AyanGarg2/Low-Power-NTT-Hardware-Accelerator-for-Lattice-Based-Post-Quantum-Cryptography/ASIC.jpeg

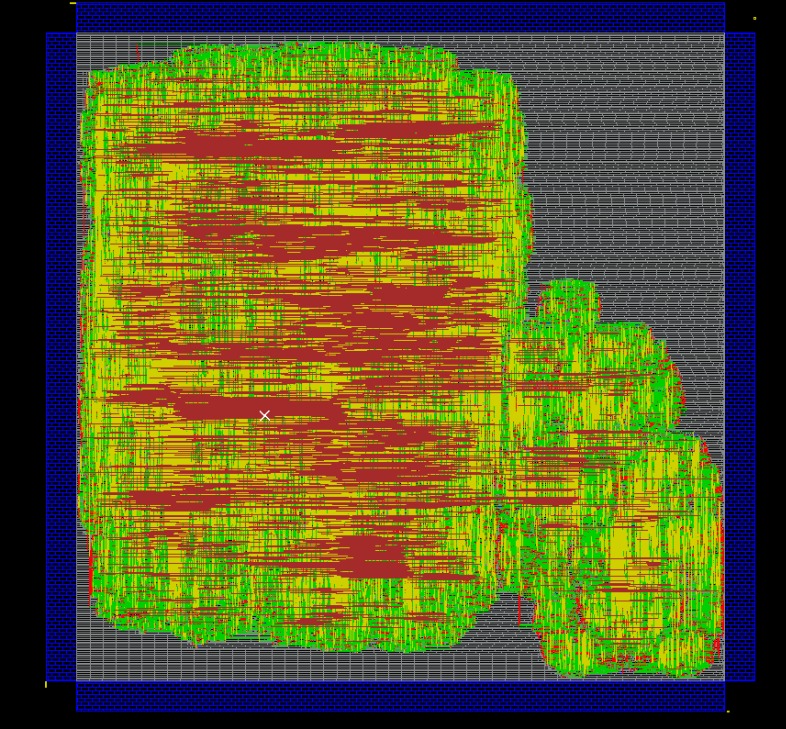
ASIC.jpeg
