AyanGarg2/Low-Power-NTT-Hardware-Accelerator-for-Lattice-Based-Post-Quantum-Cryptography/Low Power Presentation.pdf

## Efficient and Flexible Low-Power NTT for Lattice-Based Cryptography

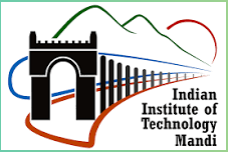
[picture p3: figure]

## Submitted To

### Dr. Srinivasu Bodapati (Associate Professor) School of Computing and Electrical Engineering Indian Institute of Technology Mandi

### Presented by Krishna Gorai(T25111), Achal Shah(T25119), Ayan Garg(B23484)

1

2

# Problem Statement

Classical cryptographic systems such as RSA and ECC are vulnerable to attacks from quantum computers.
Lattice-based cryptography has emerged as a promising post-quantum solution, but it relies heavily on polynomial multiplication.
Polynomial multiplication using conventional methods is computationally expensive and inefficient for hardware implementation.
The Number Theoretic Transform (NTT) enables faster computation, but existing implementations face challenges in power consumption and hardware complexity.

Objective:
Design an efficient and low-power hardware architecture for NTT/INTT operations suitable for lattice-based cryptographic systems.

# NTT: Number Theoretic Transform

What is NTT
A variant of FFT operating over a finite field (integers mod q) instead of complex numbers

C = NTT [ NTT(a) ∘ NTT(b)]

-1
Where ∘ = point wise multiplication

Native Multiplication: Too slow for large n, hardware dividers needed O(n²)
NTT Multiplication: n·log(n) clock cycles, single-port RAM O(n log n)

NTT hardware advantages:
1.Integer-only math
2.Small LUT (log n)

3

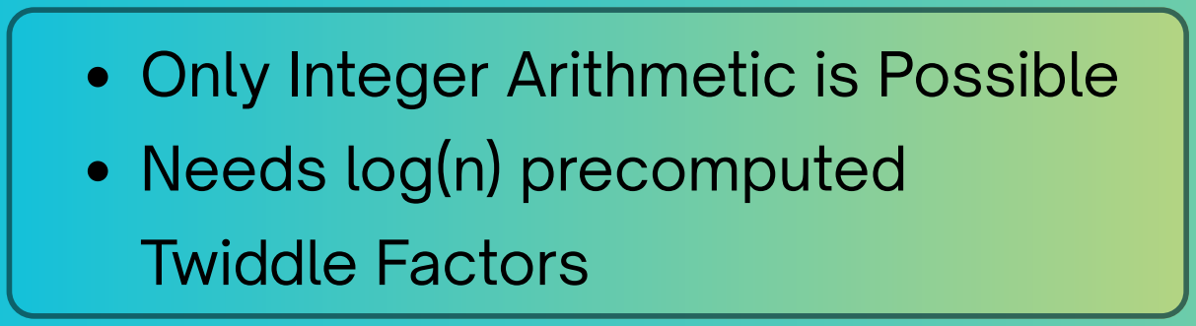
[picture p4: figure]
Only Integer Arithmetic is Possible Needs log(n) precomputed Twiddle Factors

# Algorithm: NTT Transform

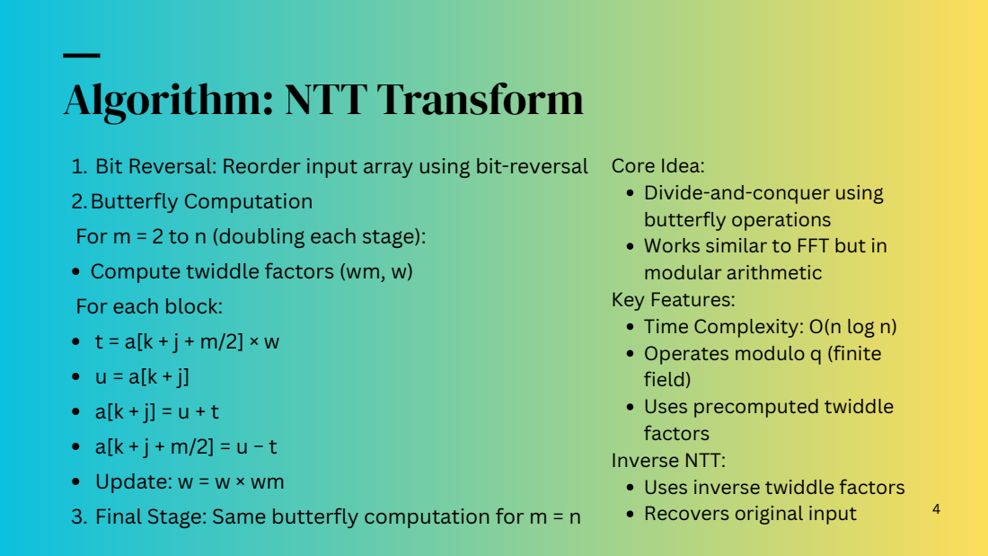
[picture p5: page 4]

1. Bit Reversal: Reorder input array using bit-reversal
2.Butterfly Computation
For m = 2 to n (doubling each stage):
Compute twiddle factors (wm, w)
For each block:
Update: w = w × wm
3. Final Stage: Same butterfly computation for m = n

Core Idea:
Divide-and-conquer using
butterfly operations
Works similar to FFT but in
modular arithmetic
Key Features:
Time Complexity: O(n log n)
Operates modulo q (finite
field)
Uses precomputed twiddle
factors
Inverse NTT:
Uses inverse twiddle factors
Recovers original input

# Algorithm: Barrett Modulo Reduction

### Input: Integer a, constants m and k Output: a mod q Steps: 1.u = (a × m) >> k 2.u = u × q 3.a = a − u 4.If a ≥ q → a = a − q Key Idea: Replaces division with multiplication + shift Efficient for hardware (used in NTT, cryptography)

5

# Algorithm: Montgomery Modulo Reduction

Input: Integer a (Montgomery form), constants R, log(R), q′
Output: a mod q
Steps:
1. u = a × q′
2. u = u AND (R − 1)
3. a = a + (u × q)
4. a = a >> log(R)
5. If a ≥ q → a = a − q
Key Idea:
Replaces division with multiplication, masking, and shift
Efficient for hardware and large integer arithmetic (used in cryptography, NTT)

6

# Algorithm: Optimized NTT Transform(First Round)

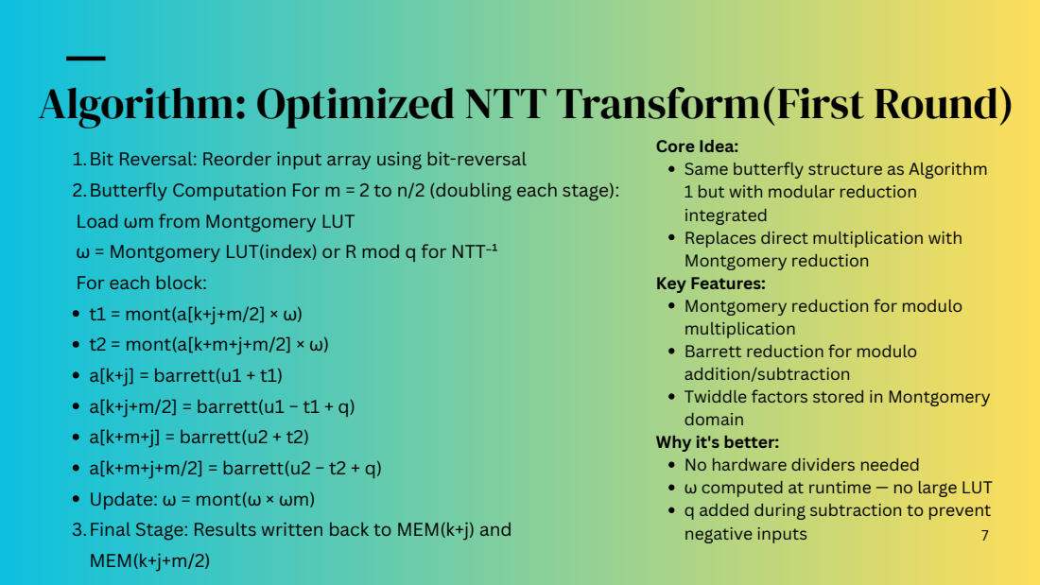
[picture p6: page 7]
negative inputs

Core Idea:
Same butterfly structure as Algorithm
1 but with modular reduction
integrated
Replaces direct multiplication with
Montgomery reduction
Key Features:
Montgomery reduction for modulo
multiplication
Barrett reduction for modulo
addition/subtraction
Twiddle factors stored in Montgomery
domain
Why it's better:
No hardware dividers needed
ω computed at runtime — no large LUT
q added during subtraction to prevent

1.Bit Reversal: Reorder input array using bit-reversal
2.Butterfly Computation For m = 2 to n/2 (doubling each stage):
Load ωm from Montgomery LUT
ω = Montgomery LUT(index) or R mod q for NTT⁻¹
For each block:
t1 = mont(a[k+j+m/2] × ω)
t2 = mont(a[k+m+j+m/2] × ω)
a[k+j] = barrett(u1 + t1)
a[k+j+m/2] = barrett(u1 − t1 + q)
a[k+m+j] = barrett(u2 + t2)
a[k+m+j+m/2] = barrett(u2 − t2 + q)
Update: ω = mont(ω × ωm)
3.Final Stage: Results written back to MEM(k+j) and
MEM(k+j+m/2)

# Algorithm: Optimized NTT Transform(Last Round)

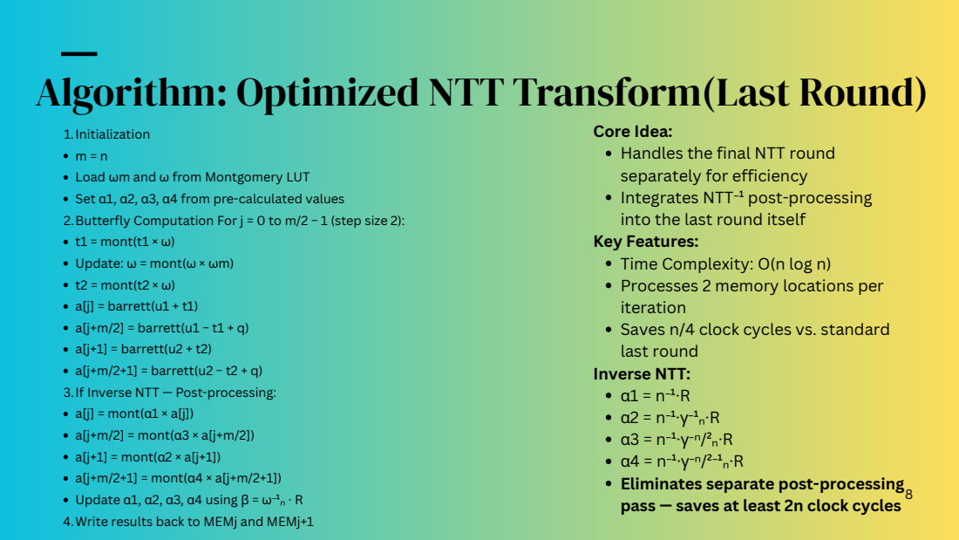
[picture p7: page 8]

Core Idea:
Handles the final NTT round
separately for efficiency
Integrates NTT⁻¹ post-processing
into the last round itself
Key Features:
Time Complexity: O(n log n)
Processes 2 memory locations per
iteration
Saves n/4 clock cycles vs. standard
last round
Inverse NTT:
Eliminates separate post-processing
pass — saves at least 2n clock cycles

1.Initialization
Load ωm and ω from Montgomery LUT
Set α1, α2, α3, α4 from pre-calculated values
2.Butterfly Computation For j = 0 to m/2 − 1 (step size 2):
t1 = mont(t1 × ω)
Update: ω = mont(ω × ωm)
t2 = mont(t2 × ω)
a[j] = barrett(u1 + t1)
a[j+m/2] = barrett(u1 − t1 + q)
a[j+1] = barrett(u2 + t2)
a[j+m/2+1] = barrett(u2 − t2 + q)
3.If Inverse NTT — Post-processing:
a[j] = mont(α1 × a[j])
a[j+m/2] = mont(α3 × a[j+m/2])
a[j+1] = mont(α2 × a[j+1])
a[j+m/2+1] = mont(α4 × a[j+m/2+1])
Update α1, α2, α3, α4 using β = ω⁻¹
4.Write results back to MEMj and MEMj+1

# Architecture of optimised NTT/INTT Transform

Four Main Modules:
RAM: Stores two 16-bit coefficients per 32-bit memory line.
Address Unit: Controls read/write addresses for RAM access.
ω/α Update Unit — Updates twiddle factor ω and scaling factors α1–α4 each cycle. Core Operation: Butterfly unit performing Montgomery multiplication and Barrett reduction.
Registers:
H1, L1: Hold high and low 16-bit coefficients from RAM.
R1–R5: Store intermediate results and enable coefficient swapping.
Red components — Additional multipliers active only during NTT⁻¹.

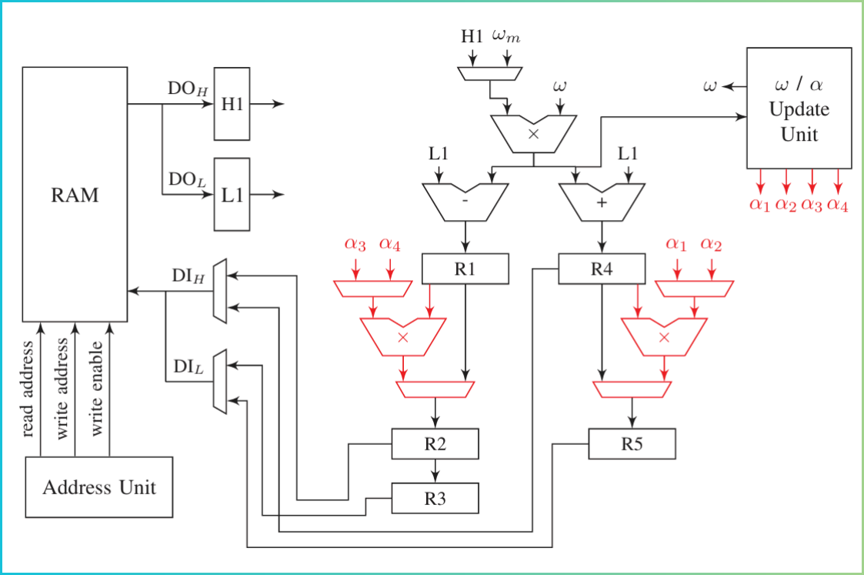
[picture p8: figure]

[1] T. Fritzmann and J. Sepulveda,

"Efficient and Flexible Low-Power NTT for Lattice-Based Cryptography,

" in Proc. IEEE HOST, McLean, VA, USA, 2019, pp. 141–150.

9

# Power Optimisation Techniques

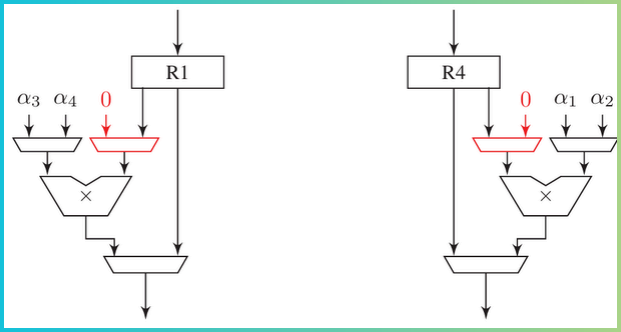
[picture p9: figure]
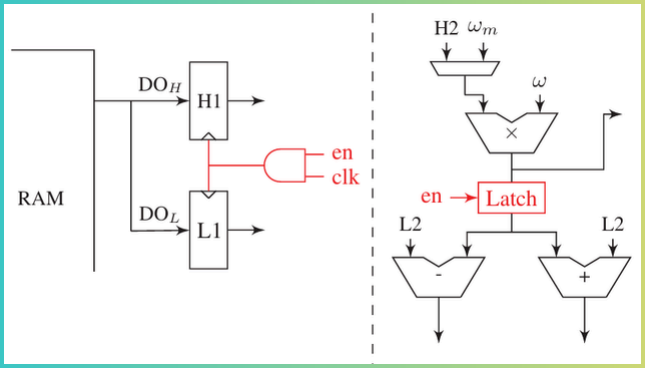
[picture p10: figure]

Operand Isolation: NTT⁻¹ Multipliers Operand Isolation: Input Registers

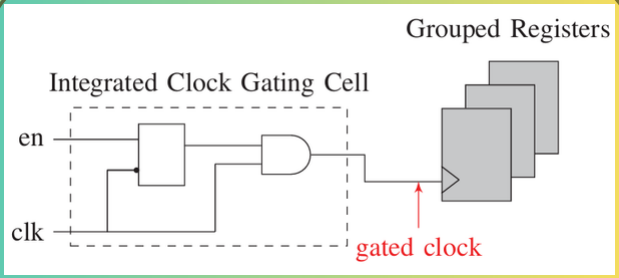
[picture p11: figure]

Clock Gating: Integrated Clock Gating Cell

Inputs to α multipliers are forced to
zero outside the last round, preventing unnecessary switching and reducing dynamic power.

Registers with a common enable signal are grouped. A gated clock disables inactive registers, reducing dynamic power to zero during idle cycles.

H1 and L1 are clock-gated during write cycles. A latch after the first multiplier blocks results from propagating when not needed.

[1] T. Fritzmann and J. Sepulveda, "Efficient and Flexible Low-Power NTT for Lattice-Based Cryptography," in Proc. IEEE HOST, McLean, VA, USA, 2019, pp. 141–150.

10

Resource | Used | Avail. | Util% | Paper[1]
LUT as Logic | 953 | 53,200 | 1.79 | —
LUT as Dist.RAM | 268 | 17,400 | 1.54 | —
LUT total | 1,221 | 53,200 | 2.30% | 980
Registers (FF) | 573 | 106,400 | 0.54 | 395
DSP48E1 | 25 | 220 | 11.36% | 26
CARRY4 | 81 | 13,300 | 0.61 | —

# FPGA Results - Zynq-7020 xc7z020clg484-1

11

Metric | Value
Total cells | 45,120
RAM (FF) | 33,500
Logic | 11,620
Total area | 854,844 µm²
Logic area | 178,473 µm²
WNS (TT) | +472 ps
Stage | WNS | Status
Post-synth | +472 ps | MET ✓
Pre-CTS | −13.1 ns | Expected
Post-CTS | +6 ps | MET ✓
Component | mW | %
Sequential | 8.312 | 47.1
Combinational | 7.434 | 42.1
Clock tree | 1.908 | 10.8
Internal | 10.802 | 61.2
Switching | 6.054 | 34.3
Leakage | 0.797 | 4.5
TOTAL | 17.653 | 100
Die size | 1700 × 1700 µm
Core size | 1276 × 1276 µm
Utilisation | ~52%
Metal layers | 5 (M1–M5)
DRC | 0 violations ✓
GDS | Exported ✓

# ASIC Results - UMC 130nm

TT corner: 1.2V, 25°C (synthesis) · SS corner: 1.08V, 125°C (P&R sign-off)
Synthesis(Genus) | Timing Closure — 25 MHz

Post-Route Power(SS)
P&R Summary

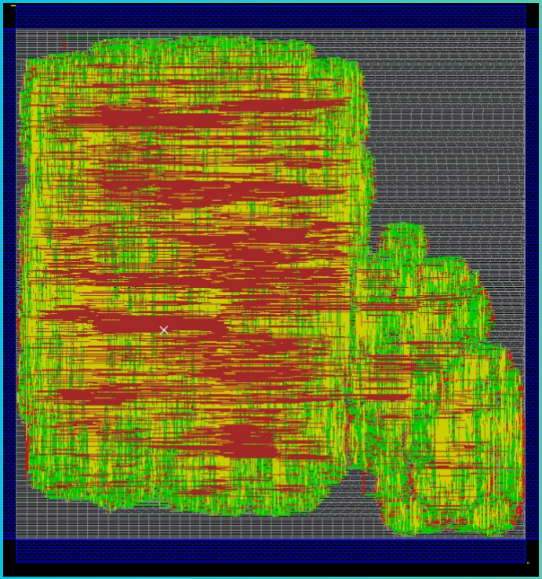
[picture p12: figure]

Fig : ASIC Implementation on UMC 130nm

12

Metric | Reference [1] (HOST 2019) | This Work | Remark
FPGA device | Zynq-7000 (Zedboard) | Zynq-7020 xc7z020 | Same family ✓
FPGA LUTs | 980 | 1,221 | ~25% higher (configurability)
FPGA DSPs | 26 | 25 | ≈ identical ✓
ASIC technology | UMC 65 nm | UMC 130 nm | Different node
ASIC frequency | 25 MHz | 25 MHz | Matched ✓
Post-route WNS | Met | +6 ps (SS corner) | Met ✓
Total cells | 14,352 | 45,120 | 3.1× due to FF RAM
Total area (µm²) | 329,598 | 854,844 | 2.6× (node + RAM)
Logic area | ~300,000 µm² | 178,473 µm² | Logic smaller ✓
RAM type | SRAM macro | FF-based (PDK limit) | No macro in PDK
P_static | 19.2 µW | 0.797 mW | 130nm leakage
P_dynamic | 2.920 mW | 16.856 mW | 5.8× (node + FF RAM)
P_total | 2.940 mW | 17.653 mW | Expected for node

## Comparison with Reference — Fritzmann & Sepulveda, IEEE HOST 2019

13

# Conclusion

What Was Achieved
RTL + Algorithms : All algorithms of [1] in synthesisable Verilog-2005: Montgomery (Alg 3), Barrett (Alg 2), NTT (Alg 4), INTT with folded post-processing (Alg 5), clock gating, operand isolation.
Verification : Python model + Vivado behavioural simulation PASSED. Forward NTT and INTT(NTT(a))=a round-trip both confirmed.
FPGA : Zynq-7020: 1,221 LUTs, 25 DSPs — matching [1].
ASIC : UMC 130nm: 25 MHz timing closure (WNS = +6 ps at SS worst-case). Post-route power 17.65 mW.

## 75 % of the reference paper [1] was implemented , except for side

channel security.
14

# References

[1] T. Fritzmann and J. Sepulveda,

"Efficient and Flexible Low-Power NTT for Lattice-Based Cryptography,

" in Proc. IEEE HOST, McLean, VA, USA, 2019, pp. 141–150.
[2] P. L. Montgomery,

"Modular Multiplication Without Trial Division,

" Mathematics of
Computation, vol. 44, no. 170, pp. 519–521, 1985.
[3] J. W. Cooley and J. W. Tukey,

"An Algorithm for the Machine Calculation of Complex Fourier Series,

" Mathematics of Computation, vol. 19, no. 90, pp. 297–301, 1965.
[4] R. Avanzi et al.,

"CRYSTALS-Kyber Algorithm Specifications and Supporting Documentation,

"
NIST PQC Round 3 Submission, 2021.

15

# Thank You

16
