AyanGarg2/Low-Power-NTT-Hardware-Accelerator-for-Lattice-Based-Post-Quantum-Cryptography/Verilog Codes/ntt_tb_n256.v

// ============================================================
// NTT/INTT Verification Testbench - n=256, q=7681
// Cross-checks Verilog output against Python golden values
// Input: a = [1,2,...,256]  Golden: a_hat[0:4]=[5327,534,6101,3299]
// ============================================================

`timescale 1ns / 1ps
`include "ntt_defines.vh"

module ntt_tb_n256;

    reg                          clk, rst_n, start, is_inverse;
    wire                         done, busy;
    reg  [`MAX_LOG_N-1:0]        cfg_log_n;
    reg  [`COEFF_WIDTH-1:0]      cfg_q, cfg_q_prime, cfg_barrett_m;
    reg  [4:0]                   cfg_barrett_k;
    reg  [`COEFF_WIDTH-1:0]      cfg_gamma1, cfg_gamma2, cfg_gamma3, cfg_gamma4;
    reg  [`COEFF_WIDTH-1:0]      cfg_beta, cfg_r_mod_q;
    reg                          ext_ram_we;
    reg  [`MEM_ADDR_WIDTH-1:0]   ext_ram_addr;
    reg  [`MEM_WIDTH-1:0]        ext_ram_din;
    wire [`MEM_WIDTH-1:0]        ext_ram_dout;
    reg                          lut_we;
    reg  [3:0]                   lut_waddr;
    reg  [`COEFF_WIDTH-1:0]      lut_wdata;
    integer errors, cyc;

    ntt_core u_dut (
        .clk(clk), .rst_n(rst_n), .start(start), .is_inverse(is_inverse),
        .done(done), .busy(busy),
        .cfg_log_n(cfg_log_n), .cfg_q(cfg_q), .cfg_q_prime(cfg_q_prime),
        .cfg_barrett_m(cfg_barrett_m), .cfg_barrett_k(cfg_barrett_k),
        .cfg_gamma1(cfg_gamma1), .cfg_gamma2(cfg_gamma2),
        .cfg_gamma3(cfg_gamma3), .cfg_gamma4(cfg_gamma4),
        .cfg_beta(cfg_beta), .cfg_r_mod_q(cfg_r_mod_q),
        .ext_ram_we(ext_ram_we), .ext_ram_addr(ext_ram_addr),
        .ext_ram_din(ext_ram_din), .ext_ram_dout(ext_ram_dout),
        .lut_we(lut_we), .lut_waddr(lut_waddr), .lut_wdata(lut_wdata)
    );

    initial clk = 0;
    always #20 clk = ~clk;

    task wr_ram;
        input [`MEM_ADDR_WIDTH-1:0] a;
        input [`MEM_WIDTH-1:0]      d;
    begin
        @(posedge clk); ext_ram_we<=1; ext_ram_addr<=a; ext_ram_din<=d;
        @(posedge clk); ext_ram_we<=0;
    end endtask

    task wr_lut;
        input [3:0]              a;
        input [`COEFF_WIDTH-1:0] d;
    begin
        @(posedge clk); lut_we<=1; lut_waddr<=a; lut_wdata<=d;
        @(posedge clk); lut_we<=0;
    end endtask

    task chk;
        input [`MEM_ADDR_WIDTH-1:0] a;
        input [`COEFF_WIDTH-1:0]    eh, el;
    begin
        ext_ram_we<=0; ext_ram_addr<=a; #1;
        if (ext_ram_dout[31:16] !== eh || ext_ram_dout[15:0] !== el) begin
            $display("  MISMATCH addr=%0d got{%0d,%0d} exp{%0d,%0d}",
                     a, ext_ram_dout[31:16], ext_ram_dout[15:0], eh, el);
            errors = errors + 1;
        end
    end endtask

    task run_ntt;
        input integer max_cyc;
    begin
        @(posedge clk); start<=1; @(posedge clk); start<=0;
        cyc = 0;
        while (!done && cyc < max_cyc) begin @(posedge clk); cyc=cyc+1; end
        if (!done) begin $display("  TIMEOUT!"); $finish; end
        $display("  Completed: %0d cycles", cyc);
        @(posedge clk);
    end endtask

    // ---- Fixed parameters (n=256, q=7681) ----
    localparam LOG_N     = 8;
    localparam Q         = 16'd7681;
    localparam Q_PRIME   = 16'd7679;
    localparam BARRETT_M = 16'd2;
    localparam BARRETT_K = 5'd14;
    localparam R_MOD_Q   = 16'd4088;
    localparam GAMMA1    = 16'd256;
    localparam GAMMA2    = 16'd5283;
    localparam GAMMA3    = 16'd5776;
    localparam GAMMA4    = 16'd6383;
    localparam BETA      = 16'd5016;
    localparam MAX_CYCLES = 6000;

    // ---- Forward NTT LUT (omega values in Montgomery domain) ----
    task load_forward_lut; begin
        wr_lut(4'd0, 16'd3593);
        wr_lut(4'd1, 16'd3777);
        wr_lut(4'd2, 16'd4499);
        wr_lut(4'd3, 16'd3985);
        wr_lut(4'd4, 16'd7560);
        wr_lut(4'd5, 16'd5593);
        wr_lut(4'd6, 16'd3266);
        wr_lut(4'd7, 16'd5255);
        wr_lut(4'd8, 16'd1242);
    end endtask

    // ---- Inverse NTT LUT (omega_inv values in Montgomery domain) ----
    task load_inverse_lut; begin
        wr_lut(4'd0, 16'd3593);
        wr_lut(4'd1, 16'd3904);
        wr_lut(4'd2, 16'd4056);
        wr_lut(4'd3, 16'd5487);
        wr_lut(4'd4, 16'd1414);
        wr_lut(4'd5, 16'd7064);
        wr_lut(4'd6, 16'd4877);
        wr_lut(4'd7, 16'd5016);
        wr_lut(4'd8, 16'd4088);
    end endtask

    // ---- Load a=[1..256] in bit-reversed RAM order ----
    task load_forward_input; begin
        wr_ram(9'd0, {16'd129, 16'd1});
        wr_ram(9'd1, {16'd193, 16'd65});
        wr_ram(9'd2, {16'd161, 16'd33});
        wr_ram(9'd3, {16'd225, 16'd97});
        wr_ram(9'd4, {16'd145, 16'd17});
        wr_ram(9'd5, {16'd209, 16'd81});
        wr_ram(9'd6, {16'd177, 16'd49});
        wr_ram(9'd7, {16'd241, 16'd113});
        wr_ram(9'd8, {16'd137, 16'd9});
        wr_ram(9'd9, {16'd201, 16'd73});
        wr_ram(9'd10, {16'd169, 16'd41});
        wr_ram(9'd11, {16'd233, 16'd105});
        wr_ram(9'd12, {16'd153, 16'd25});
        wr_ram(9'd13, {16'd217, 16'd89});
        wr_ram(9'd14, {16'd185, 16'd57});
        wr_ram(9'd15, {16'd249, 16'd121});
        wr_ram(9'd16, {16'd133, 16'd5});
        wr_ram(9'd17, {16'd197, 16'd69});
        wr_ram(9'd18, {16'd165, 16'd37});
        wr_ram(9'd19, {16'd229, 16'd101});
        wr_ram(9'd20, {16'd149, 16'd21});
        wr_ram(9'd21, {16'd213, 16'd85});
        wr_ram(9'd22, {16'd181, 16'd53});
        wr_ram(9'd23, {16'd245, 16'd117});
        wr_ram(9'd24, {16'd141, 16'd13});
        wr_ram(9'd25, {16'd205, 16'd77});
        wr_ram(9'd26, {16'd173, 16'd45});
        wr_ram(9'd27, {16'd237, 16'd109});
        wr_ram(9'd28, {16'd157, 16'd29});
        wr_ram(9'd29, {16'd221, 16'd93});
        wr_ram(9'd30, {16'd189, 16'd61});
        wr_ram(9'd31, {16'd253, 16'd125});
        wr_ram(9'd32, {16'd131, 16'd3});
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
        cfg_barrett_m=BARRETT_M; cfg_barrett_k=BARRETT_K;
        cfg_gamma1=GAMMA1; cfg_gamma2=GAMMA2;
        cfg_gamma3=GAMMA3; cfg_gamma4=GAMMA4;
        cfg_beta=BETA; cfg_r_mod_q=R_MOD_Q;
        repeat(5) @(posedge clk); rst_n=1; repeat(2) @(posedge clk);

        // ---- TEST 1: Forward NTT ----
        $display("");
        $display("================================================");
        $display("  TEST 1: Forward NTT  n=256, q=7681");
        $display("  Input: a = [1,2,...,256]");
        $display("  Golden: a_hat[0:4] = [5327, 534, 6101, 3299]");
        $display("================================================");
        load_forward_lut;
        load_forward_input;
        is_inverse <= 0;
        run_ntt(MAX_CYCLES);
        check_ntt_output;
        if (errors == 0)
            $display("  TEST 1: PASSED - all 256 coefficients match Python");
        else
            $display("  TEST 1: FAILED - %0d mismatches", errors);

        // ---- TEST 2: Inverse NTT ----
        errors = 0;
        $display("");
        $display("================================================");
        $display("  TEST 2: Inverse NTT  (round-trip check)");
        $display("  Input: NTT output from Test 1");
        $display("  Expected: [1, 2, 3, ..., 256]");
        $display("================================================");
        load_inverse_lut;
        load_inverse_input;
        is_inverse <= 1;
        run_ntt(MAX_CYCLES);
        check_intt_output;
        if (errors == 0)
            $display("  TEST 2: PASSED - INTT(NTT(a)) == a confirmed");
        else
            $display("  TEST 2: FAILED - %0d mismatches", errors);

        $display("");
        $display("================================================");
        $display("  Verilog matches Python: bit-exact verification");
        $display("================================================");
        #200; $finish;
    end

    initial begin #(MAX_CYCLES*200); $display("WATCHDOG"); $finish; end

endmodule
